diyaudioby/amp-lm3886-ad825/docs/lm3886-ad825-sch-common.JPG

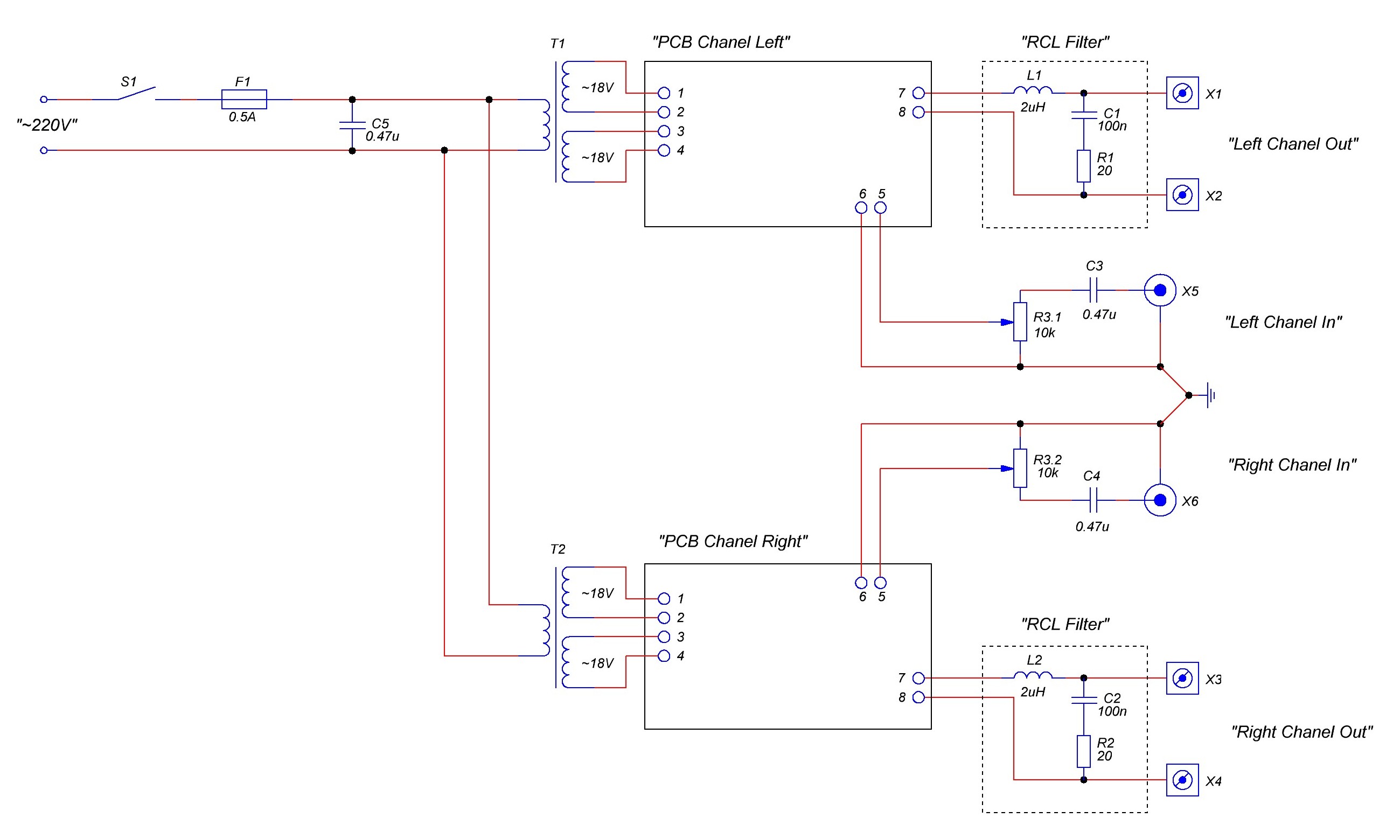
docs/lm3886-ad825-sch-common.JPG
