diyaudioby/amp-lm3886-ad825/bom/lm3886-ad825-bom.xlsx

Sheet: Комплектация
 |  |  |  | Комплектация | 2358.5
 |  |  |  | Доставка
 |  |  |  | Итого | 2358.5
Позиция | Номинал | Доп. инфо | Кол-во | Цена, рос. руб | Сумма
Платы, трансформатор
Платы |  |  | 1 | 100 | 100
Трансформатор | 60Вт, 2 x 22V x 1.3A |  | 1 | 1000 | 1000
Шестигр. стойка для п/плат М3,латунь | PCHSS-10 |  | 4 | 5 | 20
Конденсаторы SMD 1206
C1 - C5 | 0,22uF | X7R | 5
С16, C17 | 0,1uF | X7R | 2 | 3 | 6
C18 | 330pF | NPO | 1 | 0.5 | 0.5
C19 | 4,7uF | X7R | 1 | 2 | 2
C20 | 10p | NPO | 1 | 0.5 | 0.5
Конденсаторы электролитические выводные
C6 - C11 | 3300uF x 35V | Panasonic FC | 6 | 90 | 540
C14 | 470uF x 35V | Panasonic FC | 4 | 30 | 120
Резисторы SMD 1206 1% Yageo
R2 - R6 | 51 Om |  | 5
R11 | 1k |  | 1 | 0.5 | 0.5
R12 | 4,7k |  | 1 | 0.5 | 0.5
R13 | 100k |  | 1 | 0.5 | 0.5
R14, R16 | 10k |  | 2 | 0.5 | 1
R15 | 2,7k |  | 1 | 0.5 | 0.5
R17 | 33k |  | 1 | 0.5 | 0.5
Резисторы выводные 0.5Вт 5% Yageo
R7 - R10 | 470 Om 5% |  | 4
Резисторы выводные 2Вт 5%
R17 | 1R |  | 1
Диоды, стабилитроны
VD5, VD6 | 1N4744 (15V) | DO-41 | 2 | 3 | 6
VD1 - VD4 | SB560 | DO-201AD | 4
Микросхемы
DA1 | AD825 | SOIC-8 | 1 | 200 | 200
DA2 | LM3886TF |  | 1 | 360 | 360

Sheet: Оформить заказ
Таблица заказа комплектации lm3886-ad825
1. Сохранить таблицу (Файл - Скачать - Microsoft Excel)
2. Проставить нужное количество деталек (столбец Е) либо удалить
3. Заполнить контактные данные
4. Отправить на diyaudioby@gmail.com
ФИО
Адрес доставки
Пункт выдачи заказа CDEK
Телефон
Email
