diyaudioby/amp-lm3886-ad825/docs/lm3886-ad825-sch.pdf

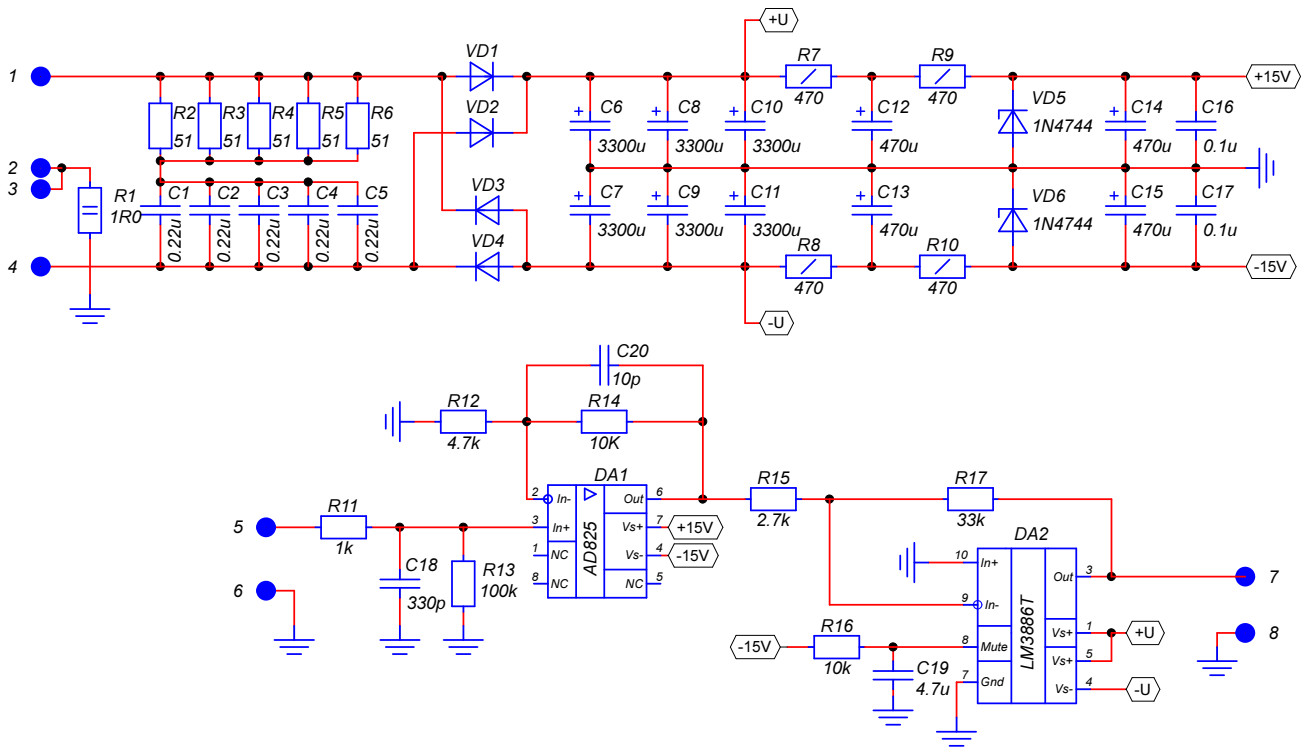
[picture p3: page 1]
