diyaudioby/amp-lm3886-ad825/(list of files, drawings)

Other design files:
pcb/lm3886-ad825.pcb
